slsp8752/atlas-tower-light-controller/images/breadboard.jpg

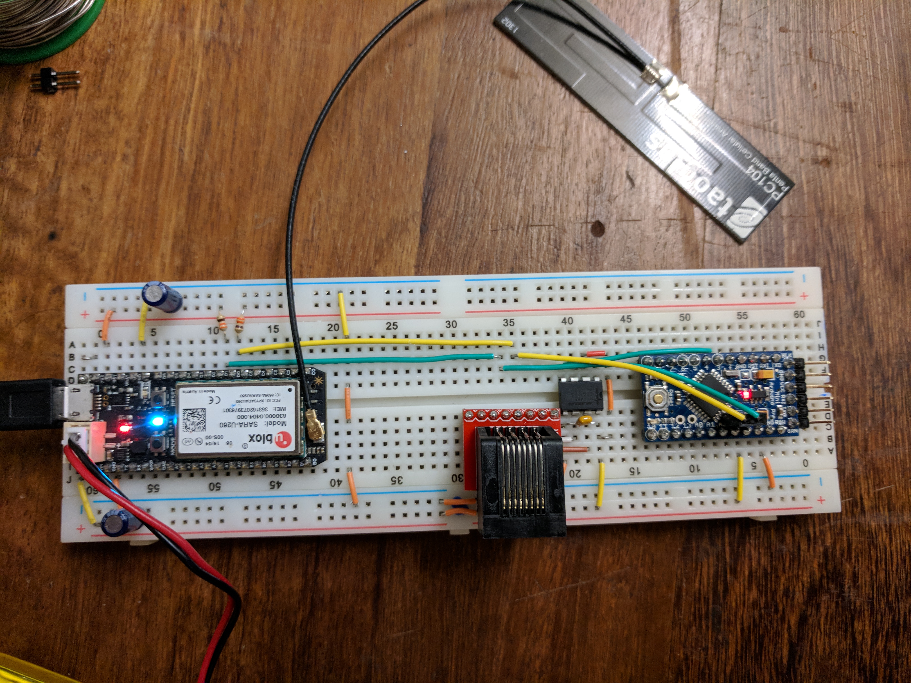
images/breadboard.jpg
