slsp8752/atlas-tower-light-controller/(commit log)

2017-04-15 Add slave driver code
2017-04-15 Created i2c master file
2017-04-16 Remove extraneous files, seperate folders, test i2c
2017-05-03 [UNTESTED] Write simple AF parser for keyframe data involving arduino function atoi()
2017-05-16 fixed typos in DMX_Slave, changed keyframe ids to be unique in DMX_Driver
    [DMX_slave.ino, dmx_driver.ino]
2017-05-16 Changed driver to use keyframe data without light number
2017-05-17 Changed Driver to send keyframes as multiple messages
2017-05-23 fixed multi keyframe sending
    [DMX_slave.ino, dmx_driver.ino]
2017-06-03 Fixed Keyframe transitioning issue
    [DMX_slave.ino, dmx_driver.ino]
2017-06-03 incoming frame number is now parsed to an int before being used.
2017-06-03 Fixed parser, changed keyframe send interval
    [DMX_slave.ino, dmx_driver.ino]
2017-06-06 initialize rails server
2017-09-04 Added delete button to frames
2017-09-04 Added delete functionality for first frame
2017-09-04 re-enable 'new keyframe' button after deleting frames
2017-09-05 Added send keyframe button
2017-11-06 Added dynamic error reporting per framepair
    [DMX_slave.ino, dmx_driver.ino]
